Pirx3D/pirx/(list of files, cad)

Other CAD files:
Assembly/Case/boardCaseBack.ipt
Assembly/Case/boardCaseBottom.ipt
Assembly/Case/boardCaseSide.ipt
Assembly/Case/caseBack.ipt
Assembly/Case/caseBottom.ipt
Assembly/Case/caseFront.ipt
Assembly/Case/caseLeft.ipt
Assembly/Case/caseRight.ipt
Assembly/Case/caseTop.ipt
Assembly/SmallPieces/bowdenHolder.ipt
Assembly/SmallPieces/shaftPlug22.ipt
Assembly/SmallPieces/shaftPlug24.ipt
Assembly/SmallPieces/spoolHolder.iam
Assembly/SmallPieces/spoolHolderHolder.ipt
Assembly/SmallPieces/spoolHolder_a.ipt
Assembly/SmallPieces/spoolHolder_b.ipt
Assembly/SmallPieces/spoolHolder_c.ipt
Assembly/SmallPieces/xDriveShaft.ipt
Assembly/SmallPieces/xDriveShaftBack.iam
Assembly/SmallPieces/xDriveShaftFront.iam
Assembly/SmallPieces/xDriveShaftSupport.ipt
Assembly/SmallPieces/xDriveShaftSupportb.ipt
Assembly/SmallPieces/xMotor.iam
Assembly/SmallPieces/xMotorSpacer.ipt
Assembly/SmallPieces/xShaft.iam
Assembly/SmallPieces/xShaftHolder.ipt
Assembly/StockComponents/625ZZ_bearing.ipt
Assembly/StockComponents/695ZZ_bearing.ipt
Assembly/StockComponents/LM08UU.ipt
Assembly/StockComponents/NEMA17Stepper.ipt
Assembly/StockComponents/blowerFan50x15.ipt
Assembly/StockComponents/endstop.ipt
Assembly/StockComponents/endstopLever.ipt
Assembly/StockComponents/fan_60_60_10.ipt
Assembly/StockComponents/flexibleShaftCoupling.ipt
Assembly/StockComponents/gt2Belt188.ipt
Assembly/StockComponents/gt2Belt600.ipt
Assembly/StockComponents/gt2Belt760.ipt
Assembly/StockComponents/gt2_20_pulley.ipt
Assembly/StockComponents/printrboard.ipt
Assembly/StockComponents/trapeziodalNut10x2.ipt
Assembly/XCars/Xcr.iam
Assembly/XCars/XcrLeft.iam
Assembly/XCars/XcrLeftBeltTensioner.ipt
Assembly/XCars/XcrLeftPulleyAlu.ipt
Assembly/XCars/XcrLeftPulleyShaft.ipt
Assembly/XCars/XcrLeft_a.ipt
Assembly/XCars/XcrLeft_b.ipt
Assembly/XCars/XcrLeft_c.ipt
Assembly/XCars/XcrRight.iam
Assembly/XCars/XcrRightTop.ipt
Assembly/XCars/XcrRightXEndstopTrigger.ipt
Assembly/XCars/XcrRight_a.ipt
Assembly/XCars/XcrRight_b.ipt
Assembly/XCars/XcrRight_c.ipt
Assembly/XCars/Xshaft.ipt
Assembly/XCars/Yshaft.ipt
Assembly/YCar/dysza_abs2.ipt
Assembly/YCar/exAluBase.ipt
Assembly/YCar/exBolt.ipt
Assembly/YCar/exHeaterBlock.ipt
Assembly/YCar/exLever.ipt
Assembly/YCar/exNozzle.ipt
Assembly/YCar/exStSteelTube.ipt
Assembly/YCar/exTeflonTube.ipt
Assembly/YCar/exTop.ipt
Assembly/YCar/yCar.iam
Assembly/YCar/yCarBeltTensioner.ipt
Assembly/YCar/yCarBeltTensionerHolder.ipt
Assembly/YCar/yCarBottom.ipt
Assembly/YCar/yCarMid_a.ipt
Assembly/YCar/yCarMid_b.ipt
Assembly/YCar/yCarMid_c.ipt
Assembly/YCar/yCarMid_d.ipt
Assembly/YCar/yCarTop.ipt
Assembly/YCar/yCarTopper.ipt
Assembly/YCar/yCarWireHolder.ipt
Assembly/ZCar/DIN7991x30.ipt
Assembly/ZCar/Zshaft.ipt
Assembly/ZCar/trapeziodialScrew10x2.ipt
Assembly/ZCar/zCar.iam
Assembly/ZCar/zCarBack.ipt
Assembly/ZCar/zCarFront.ipt
Assembly/ZCar/zCarNutHolder.ipt
Assembly/ZCar/zCarPlate.ipt
Assembly/ZCar/zCarPlexiBed.ipt
Assembly/ZCar/zCar_a.ipt
Assembly/ZCar/zCar_b.ipt
Assembly/ZCar/zCar_c.ipt
Assembly/ZCar/zDrive.iam
Assembly/pirxMainAssembly.iam
