Pirx3D/pirx/Assembly/Pdfs/exAluBase.pdf

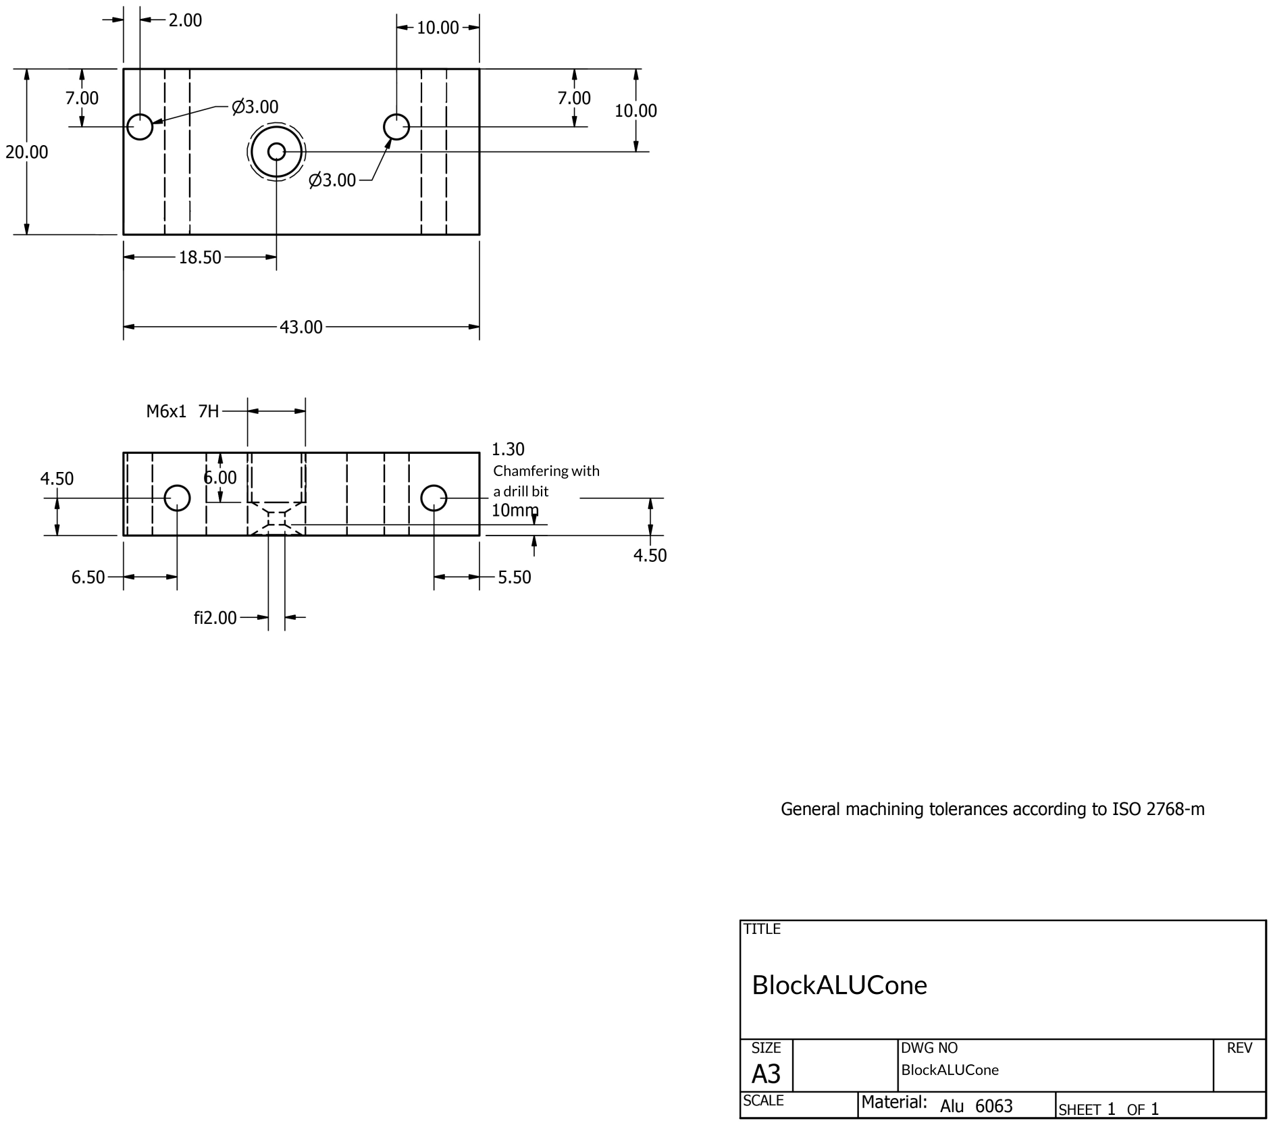
[picture p1: page 1]

Chamferingwith
adrillbit

BlockALUCone

# BlockALUCone
