Pirx3D/pirx/Assembly/Pdfs/exBolt.pdf

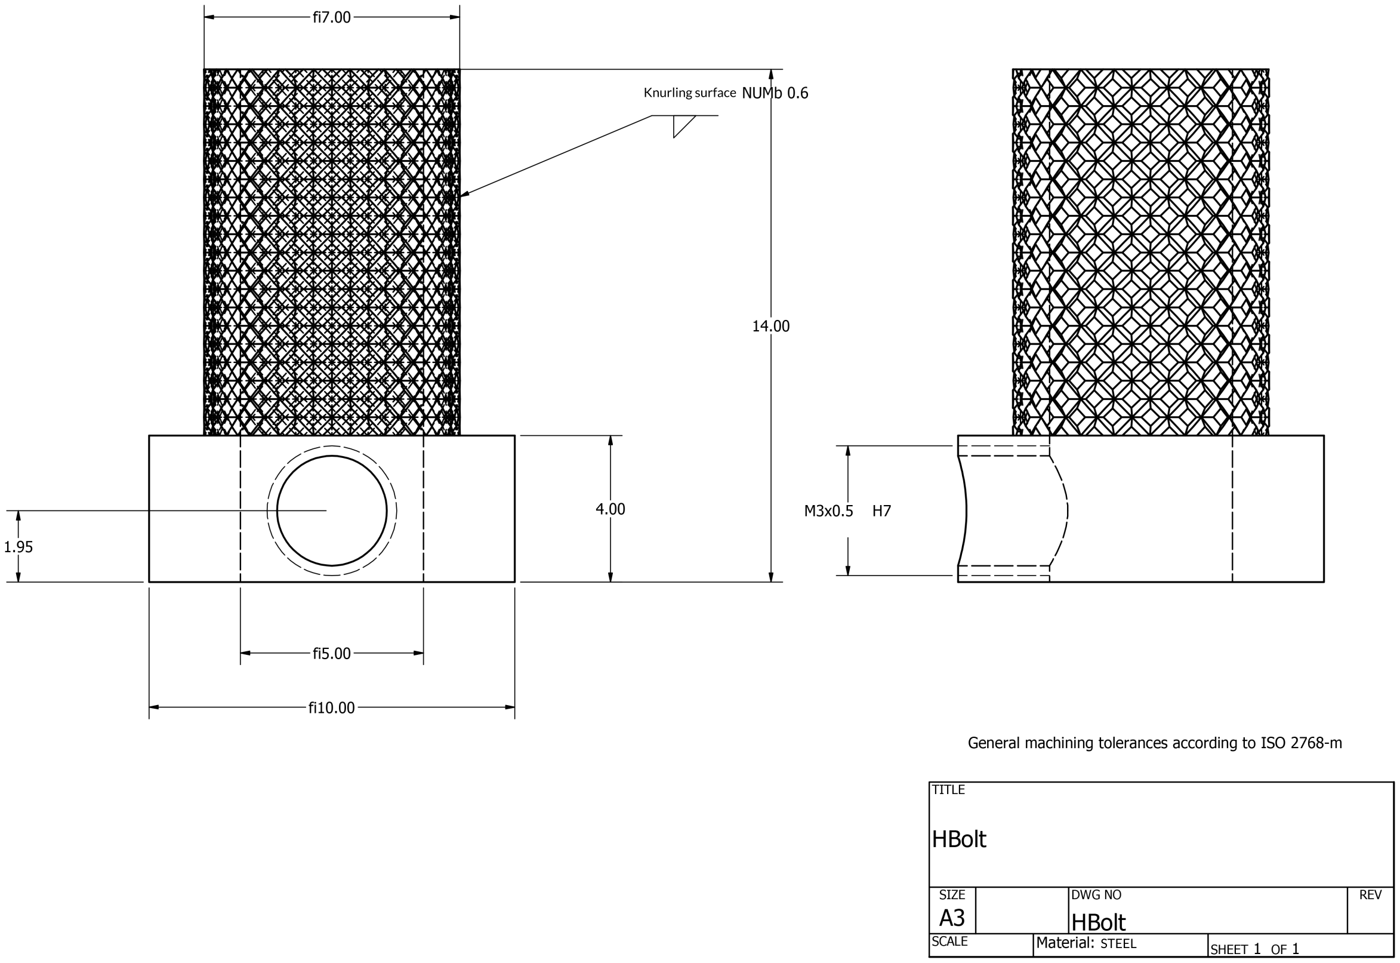
[picture p2: page 1]

Knurlingsurface

STEEL
