Pirx3D/pirx/Assembly/Pdfs/exHeatedBlock.pdf

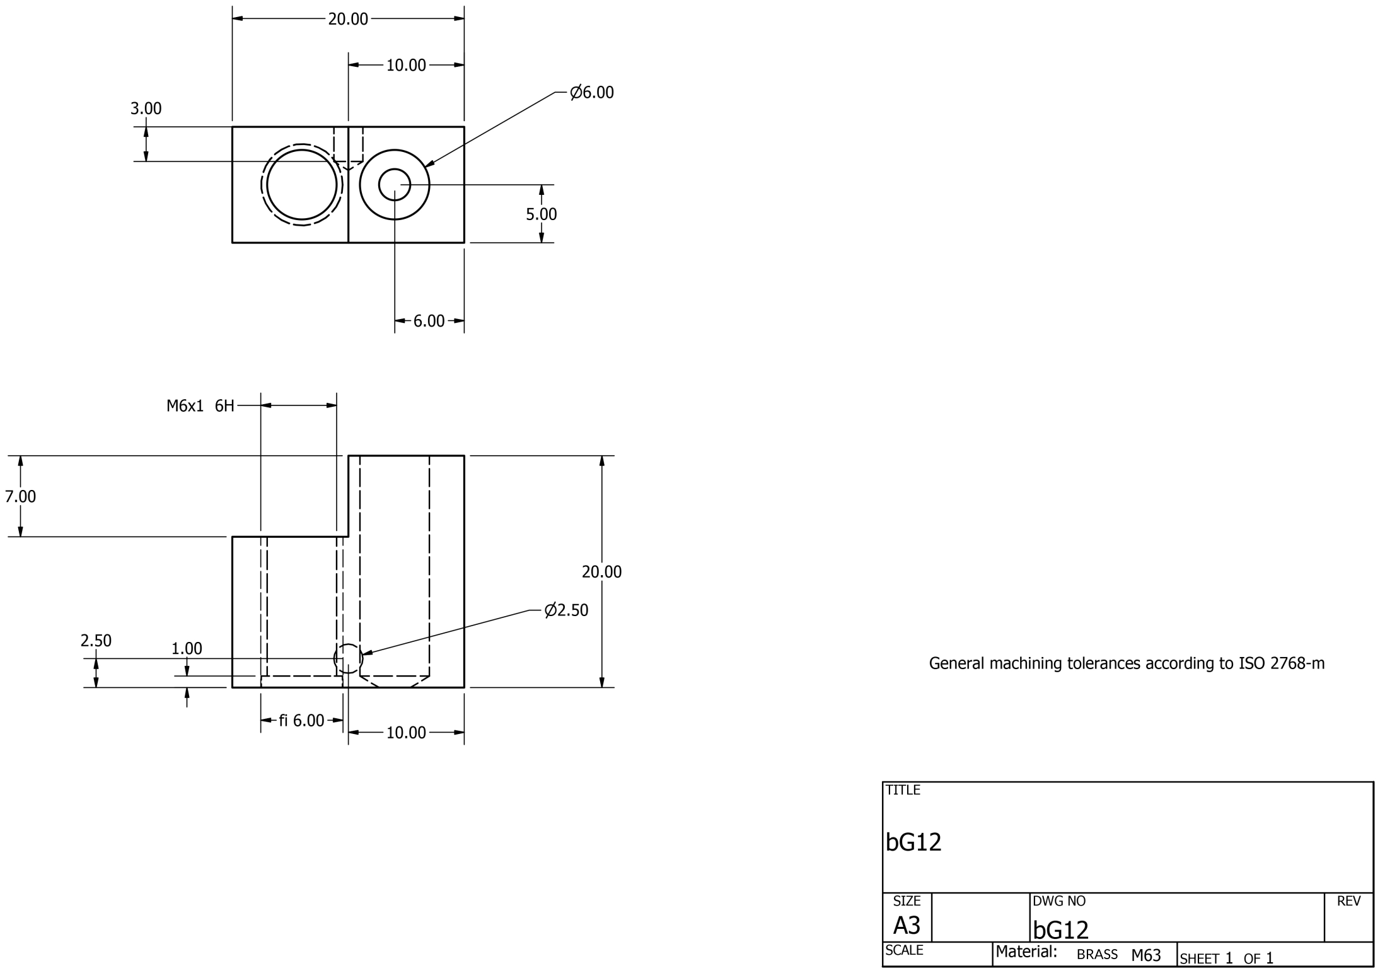
[picture p3: page 1]

BRASS
