Pirx3D/pirx/Assembly/Pdfs/exStSteelTube.pdf

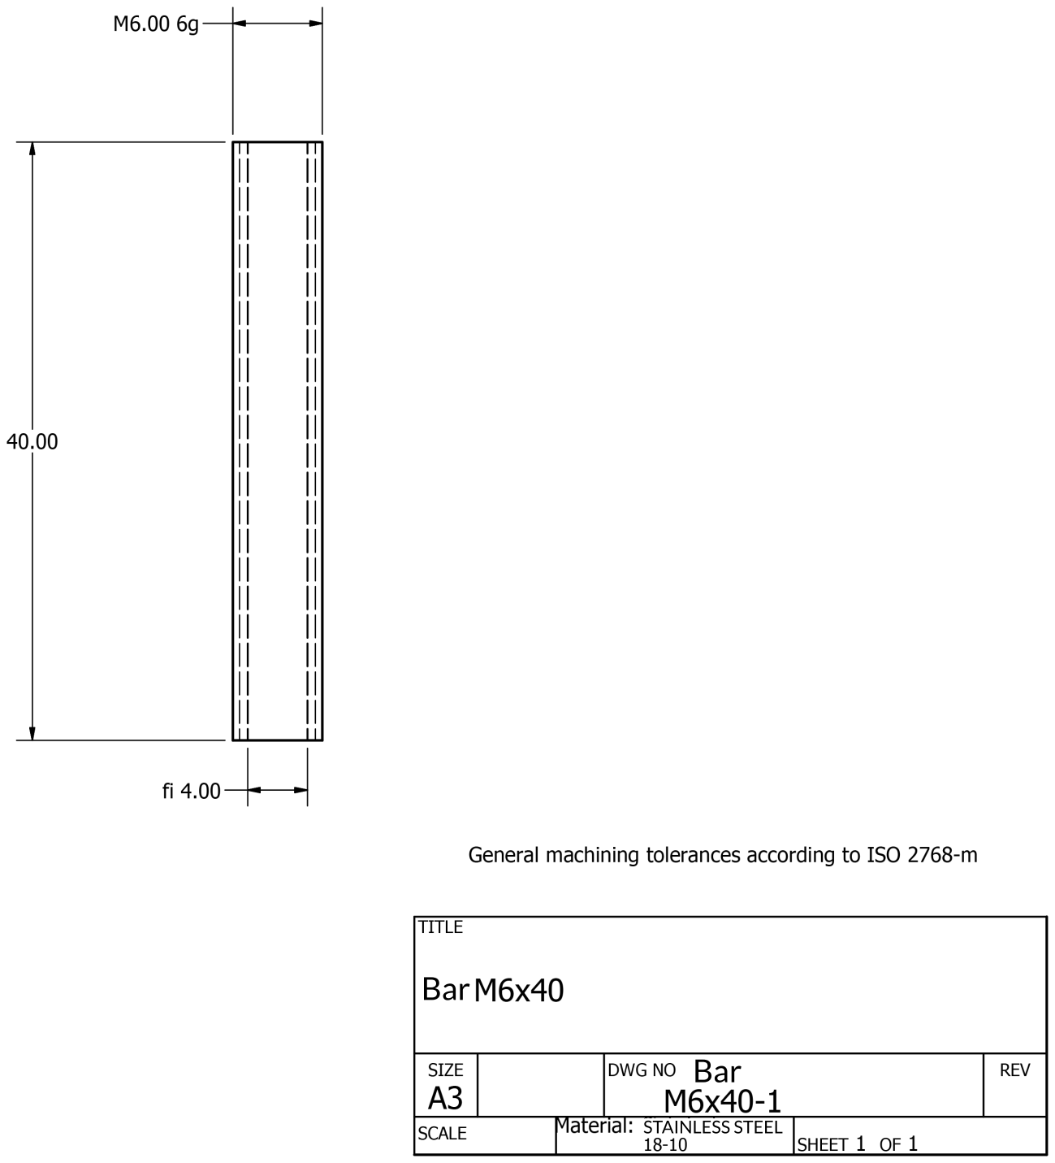
[picture p4: page 1]

# Bar

# Bar

STAINLESSSTEEL
