Pirx3D/pirx/Assembly/Pdfs/SCREWTr10x2.pdf

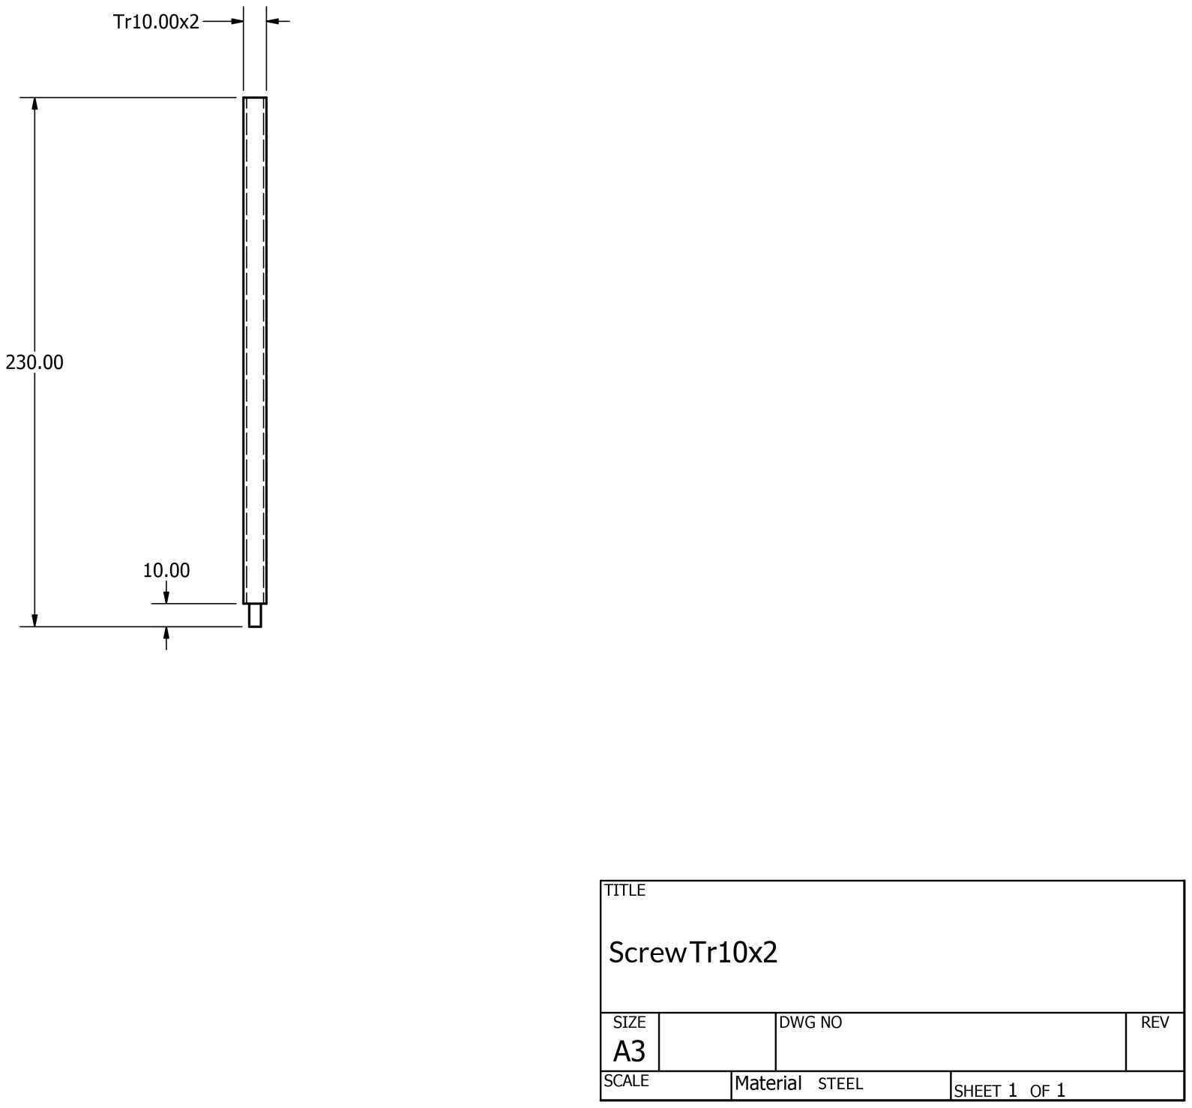
[picture p5: page 1]

STEEL
