Pirx3D/pirx/Board/Pirxboard.brd

## EAGLE design Board/Pirxboard.brd (2015-02-02)

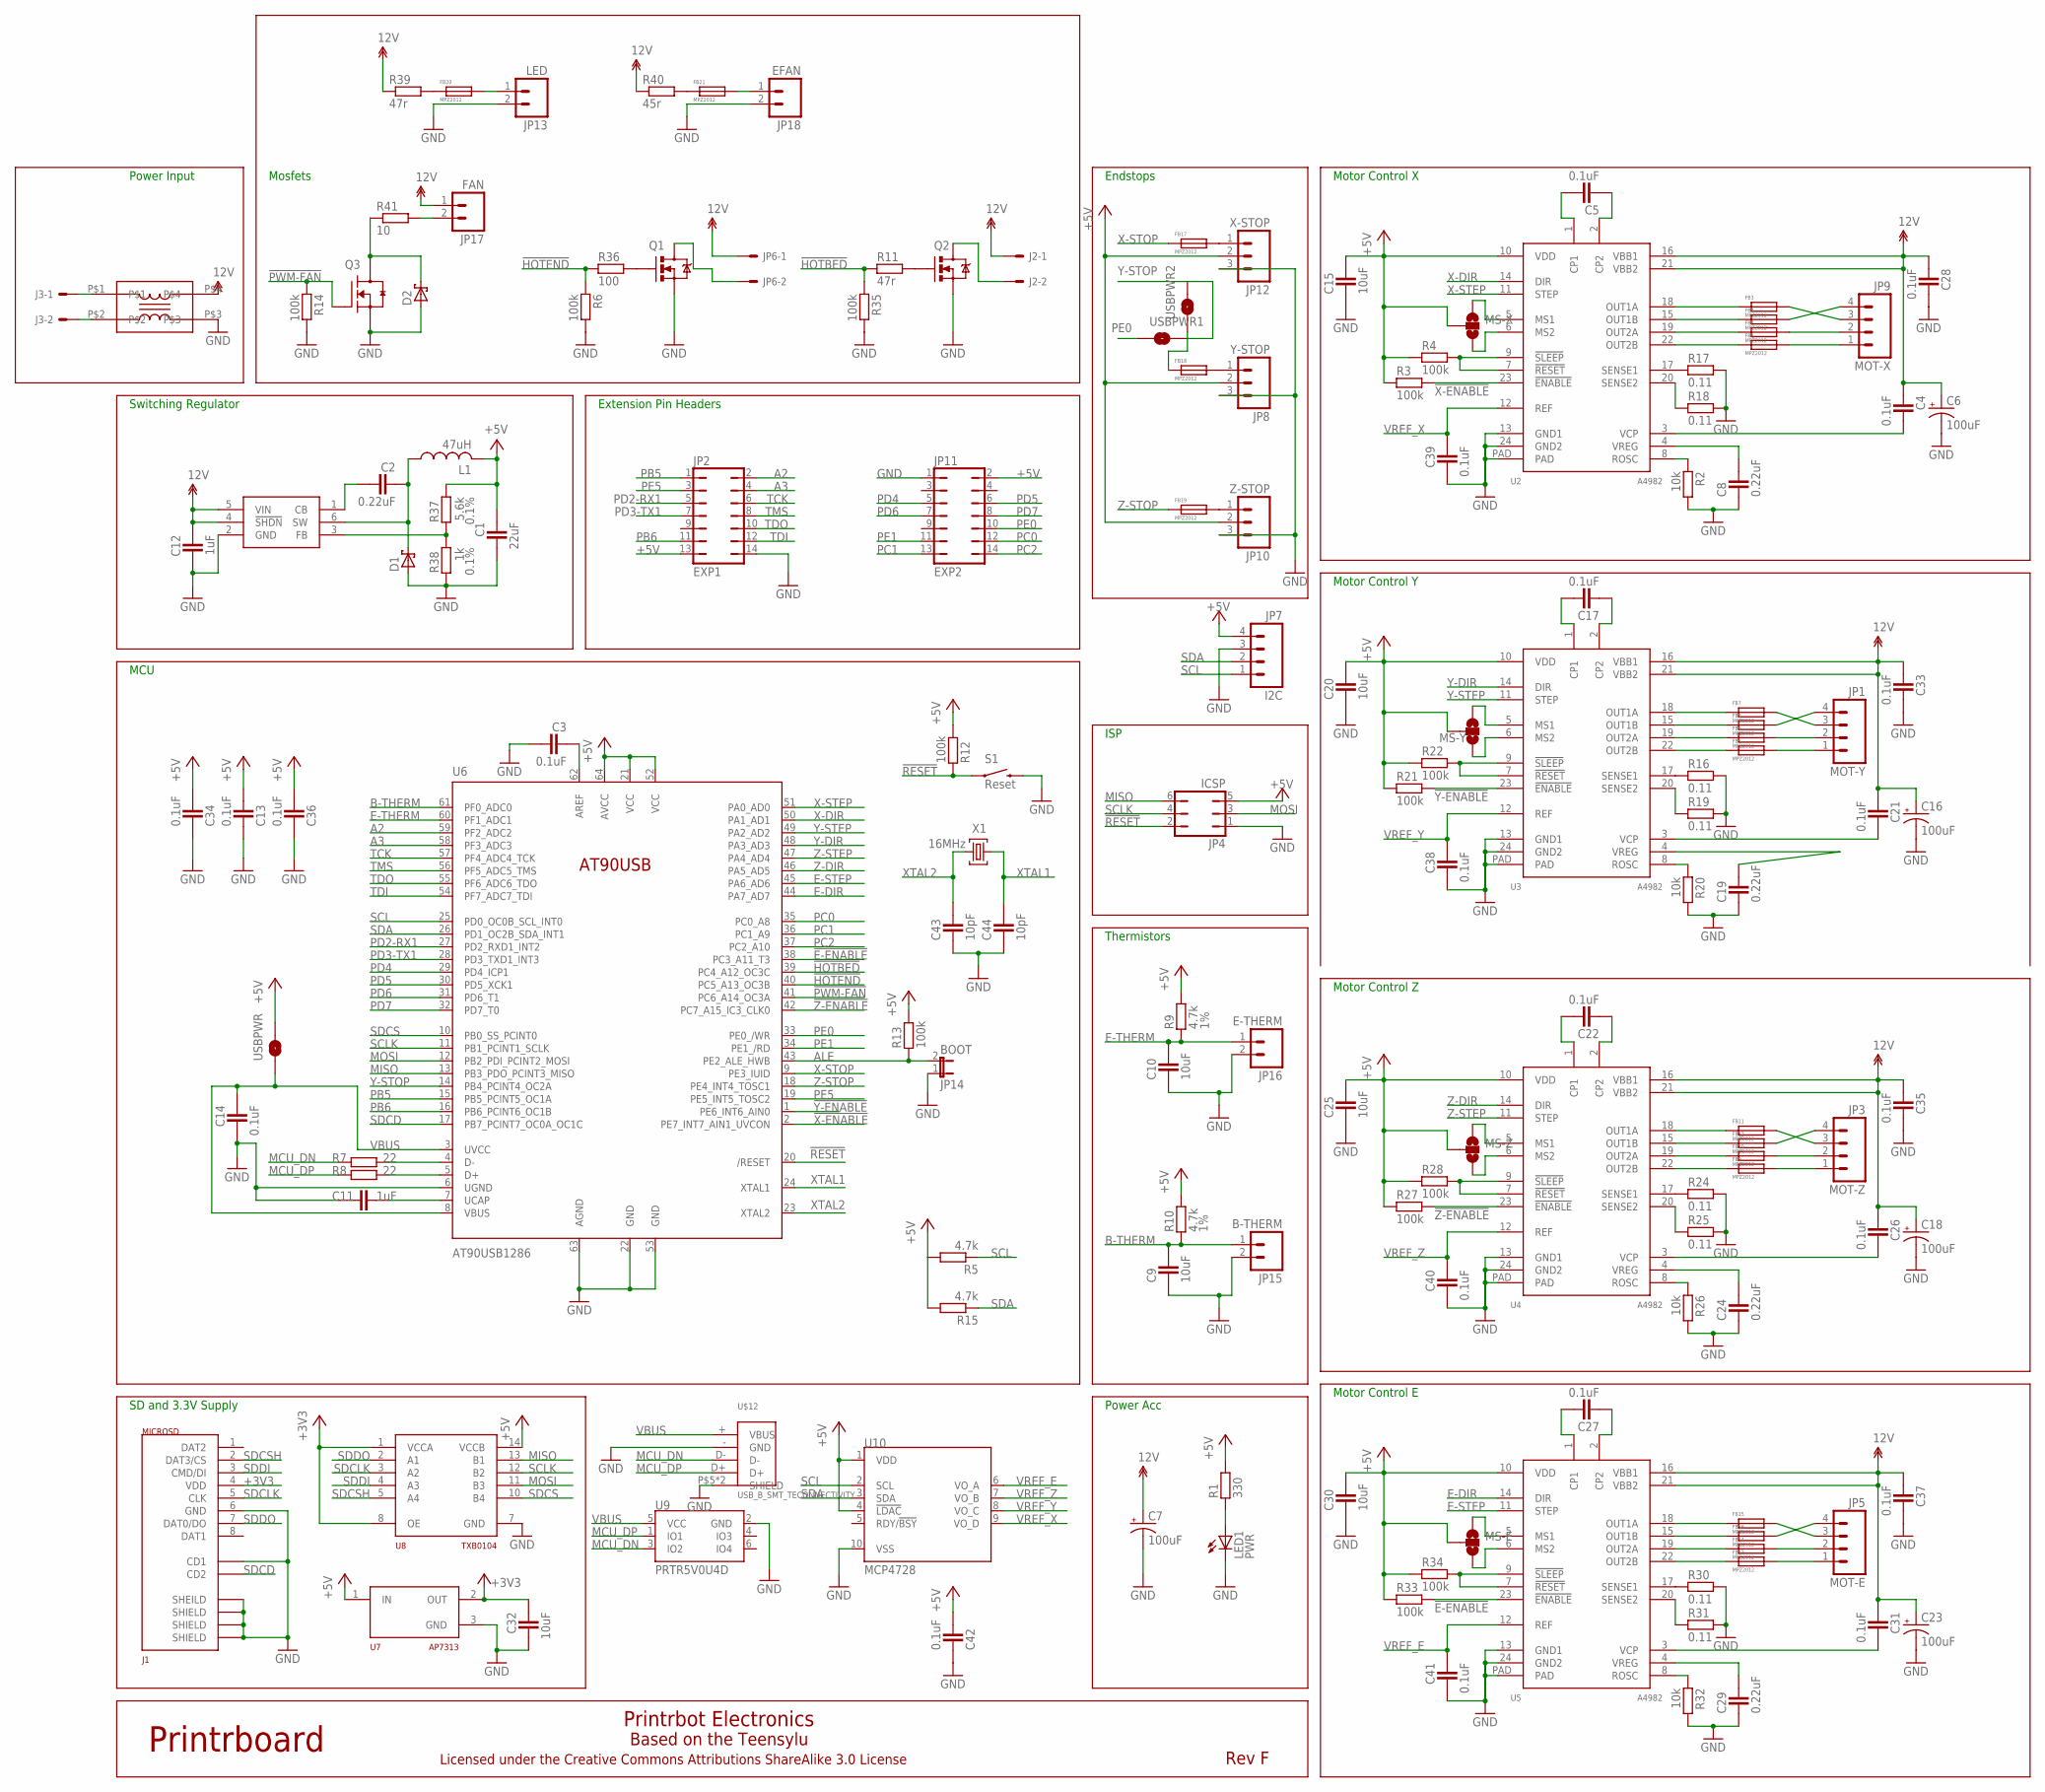
[picture p6: schematic Pirxboard.sch]

Parts:
C1: 22uF; CAPC2012X145AN
C2, C8, C19, C24, C29: 0.22uF; CAPC2012X145AN
C3, C4, C5, C13, C14, C17, C21, C22, C26, C27, C28, C31, C33, C34, C35, C36, C37, C38, C39, C40, C41, C42: 0.1uF; CAPC2012X145AN
C6, C7, C16, C18, C23: 100uF; PANASONIC_D
C9, C10, C15, C20, C25, C30, C32: 10uF; CAPC2012X145AN
C11, C12: 1uF; CAPC2012X145AN
C43, C44: 10pF; CAPC2012X145AN
D1, D2: SCH-DIODESMA; SMA
FB1, FB2, FB3, FB4, FB5, FB6, FB7, FB8, FB9, FB10, FB11, FB12, FB13, FB14, FB15, FB16, FB17, FB18, FB19, FB20, FB21: MPZ2012; FB2012
J1: MICROSD; AMPHENOL-MICROSD
J2, J3: PHOENIX-2POS-5MM-SCREW; PHOENIX-5MM-2POS
JP1: MOT-Y; MOLEX-1X4
JP2: EXP1; JP7Q
JP3: MOT-Z; MOLEX-1X4
JP4: ICSP; JP3Q
JP5: MOT-E; MOLEX-1X4
JP6: PHOENIX-2POS-5MM-SCREW; PHOENIX-5MM-2POS
JP7: I2C; MOLEX-1X4
JP8: Y-STOP; MOLEX-1X3
JP9: MOT-X; MOLEX-1X4
JP10: Z-STOP; MOLEX-1X3
JP11: EXP2; JP7Q
JP12: X-STOP; MOLEX-1X3
JP13: LED; 1X02
JP14: BOOT; 1X02
JP15: B-THERM; 1X02
JP16: E-THERM; 1X02
JP17: FAN; 1X02
JP18: EFAN; 1X02
L1: 47uH; SDR1006
LED1: PWR; CHIP-LED0805
MS-E: SOLDERJUMPER_2WAYCONNECTED; SJ_3_CONNECTED
MS-X: SOLDERJUMPER_2WAYCONNECTED; SJ_3_CONNECTED
MS-Y: SOLDERJUMPER_2WAYCONNECTED; SJ_3_CONNECTED
MS-Z: SOLDERJUMPER_2WAYCONNECTED; SJ_3_CONNECTED
Q1, Q2: RFP30N06LE; TO220V
Q3: RFP30N06LE; SOT95P280X135-3N
R1: 330; RESC2012X70N
R2, R20, R26, R32: 10k; RESC2012X70N
R3, R4, R6, R12, R13, R14, R21, R22, R27, R28, R33, R34, R35: 100k; RESC2012X70N
R5, R15: 4.7k; RESC2012X70N
R7, R8: 22; RESC2012X70N
R9, R10: 4.7k; RESC2012X70N; TOLERANCE 1%
R11: 47r; RESC2012X70N
R16, R17, R18, R19, R24, R25, R30, R31: 0.11; RESC2012X70N
R36: 100; RESC2012X70N
R37: 5.6k; RESC2012X70N; TOLERANCE 0.1%
R38: 1k; RESC2012X70N; TOLERANCE 0.1%
R39: 47r; R2512
R40: 45r; R2512
R41: 10; R2512
S1: Reset; TACTILE_SWITCH_TALL
U1: LM2841; TSOT6
U2, U3, U4, U5: A4982; TSSOP-24
U6: AT90USB1286; TQFP64-2
U7: AP7313; SOT23C
U8: TXB0104; TSSOP14
U9: PRTR5V0U4D; SOT23-6
U10: MCP4728; MSOP10
U$8: ACM1513-551-2PLACM1513; ACM1513
U$12: USB_B_SMT_TECONNECTIVITY; TECONECTIVITYUSBBSMT
USBPWR, USBPWR1, USBPWR2: SOLDERJUMPERNO; SJ_2S-NO
X1: 16MHz; NDK-XTAL

Connections:
12V: C4.1, C6.+, C7.+, C12.1, C16.+, C18.+, C21.1, C23.+, C26.1, C28.1, C31.1, C33.1, C35.1, C37.1, J2.P$1, JP6.P$1, JP17.1, R39.1, R40.1, U1.4 (!SHDN), U1.5 (VIN), U2.16 (VBB1), U2.21 (VBB2), U3.16 (VBB1), U3.21 (VBB2), U4.16 (VBB1), U4.21 (VBB2), U5.16 (VBB1), U5.21 (VBB2), U$8.P$4
!E-ENABLE: R33.2, U5.23 (!ENABLE), U6.38 (PC3_A11_T3)
!HOTBED: R11.1, R35.1, U6.39 (PC4_A12_OC3C)
!HOTEND: R6.1, R36.1, U6.40 (PC5_A13_OC3B)
!PWM-FAN: Q3.1 (G), R14.1, U6.41 (PC6_A14_OC3A)
!RESET: JP4.2, R12.1, S1.A2 (1), U6.20 (/RESET)
!X-ENABLE: R3.2, U2.23 (!ENABLE), U6.2 (PE7_INT7_AIN1_UVCON)
!Y-ENABLE: R21.2, U3.23 (!ENABLE), U6.1 (PE6_INT6_AIN0)
!Z-ENABLE: R27.2, U4.23 (!ENABLE), U6.42 (PC7_A15_IC3_CLK0)
+3V3: C32.1, J1.4 (VDD), U7.2 (OUT), U8.1 (VCCA), U8.8 (OE)
+5V: C1.1, C13.2, C15.2, C20.2, C25.2, C30.2, C34.2, C36.2, C42.2, JP2.13, JP4.5, JP7.4, JP8.2, JP10.2, JP11.2, JP12.2, L1.P$2 (2), MS-E.2, MS-X.2, MS-Y.2, MS-Z.2, R1.2, R3.1, R4.1, R5.2, R9.2, R10.2, R12.2, R13.2, R15.2, R21.1, R22.1, R27.1, R28.1, R33.1, R34.1, R37.1, U2.10 (VDD), U3.10 (VDD), U4.10 (VDD), U5.10 (VDD), U6.21 (VCC), U6.52 (VCC), U6.64 (AVCC), U7.1 (IN), U8.14 (VCCB), U10.1 (VDD), U10.4 (!LDAC), USBPWR.2
A2: JP2.2, U6.59 (PF2_ADC2)
A3: JP2.4, U6.58 (PF3_ADC3)
ALE: JP14.2, R13.1, U6.43 (PE2_ALE_HWB)
AREF: C3.1, U6.62 (AREF)
B-THERM: C9.2, JP15.1, R10.1, U6.61 (PF0_ADC0)
E-DIR: U5.14 (DIR), U6.44 (PA7_AD7)
E-STEP: U5.11 (STEP), U6.45 (PA6_AD6)
E-THERM: C10.2, JP16.1, R9.1, U6.60 (PF1_ADC1)
GND: C1.2, C3.2, C6.-, C7.-, C8.1, C9.1, C10.1, C11.1, C12.2, C13.1, C14.2, C15.1, C16.-, C18.-, C19.1, C20.1, C23.-, C24.1, C25.1, C28.2, C29.1, C30.1, C32.2, C33.2, C34.1, C35.2, C36.1, C37.2, C38.2, C39.2, C40.2, C41.2, C42.1, C43.1, C44.1, D1.A, D2.A, J1.6 (GND), J1.C1 (SHEILD), J1.C2 (SHIELD), J1.C3 (SHIELD), J1.C4 (SHIELD), J1.CD1, JP2.14, JP4.1, JP7.3, JP8.3, JP10.3, JP11.1, JP12.3, JP13.2, JP14.1, JP15.2, JP16.2, JP18.2, LED1.C, Q1.3 (S), Q2.3 (S), Q3.2 (S), R2.2, R6.2, R14.2, R16.2, R17.2, R18.2, R19.2, R20.2, R24.2, R25.2, R26.2, R30.2, R31.2, R32.2, R35.2, R38.2, S1.B2 (2), U1.2 (GND), U2.13 (GND1), U2.24 (GND2), U2.PAD, U3.13 (GND1), U3.24 (GND2), U3.PAD, U4.13 (GND1), U4.24 (GND2), U4.PAD, U5.13 (GND1), U5.24 (GND2), U5.PAD, U6.6 (UGND), U6.22 (GND), U6.53 (GND), U6.63 (AGND), U7.3 (GND), U8.7 (GND), U9.2 (GND), U10.10 (VSS), U$8.P$3, U$12.- (GND), U$12.P$5 (SHIELD), U$12.P$6 (SHIELD)
HOTBED-GND: J2.P$2, Q2.2 (D)
HOTEND-GND: JP6.P$2, Q1.2 (D)
MCU_DN: R7.1, U9.3 (IO2), U$12.D-
MCU_DP: R8.1, U9.1 (IO1), U$12.D+
MISO: JP4.6, U6.13 (PB3_PDO_PCINT3_MISO), U8.13 (B1)
MOSI: JP4.3, U6.12 (PB2_PDI_PCINT2_MOSI), U8.11 (B3)
unnamed: LED1.A, R1.1
unnamed: D2.C, Q3.3 (D), R41.1
unnamed: R7.2, U6.4 (D-)
unnamed: R8.2, U6.5 (D+)
unnamed: JP17.2, R41.2
unnamed: FB4.P$1 (1), U2.15 (OUT1B)
unnamed: Q2.1 (G), R11.2
unnamed: FB2.P$1 (1), U2.19 (OUT2A)
unnamed: C11.2, U6.7 (UCAP)
unnamed: FB3.P$2 (2), JP9.3
unnamed: C5.2, U2.1 (CP1)
unnamed: C5.1, U2.2 (CP2)
unnamed: R2.1, U2.8 (ROSC)
unnamed: R17.1, U2.17 (SENSE1)
unnamed: R18.1, U2.20 (SENSE2)
unnamed: C4.2, U2.3 (VCP)
unnamed: FB4.P$2 (2), JP9.4
unnamed: FB20.P$2 (2), JP13.1
unnamed: C8.2, U2.4 (VREG)
unnamed: FB1.P$1 (1), U2.22 (OUT2B)
unnamed: R4.2, U2.7 (!RESET), U2.9 (!SLEEP)
unnamed: R37.2, R38.1, U1.3 (FB)
unnamed: FB3.P$1 (1), U2.18 (OUT1A)
unnamed: FB7.P$1 (1), U3.18 (OUT1A)
unnamed: FB8.P$1 (1), U3.15 (OUT1B)
unnamed: FB8.P$2 (2), JP1.4
unnamed: MS-X.1, U2.5 (MS1)
unnamed: MS-X.3, U2.6 (MS2)
unnamed: C17.2, U3.1 (CP1)
unnamed: C17.1, U3.2 (CP2)
unnamed: FB7.P$2 (2), JP1.3
unnamed: R19.1, U3.20 (SENSE2)
unnamed: FB21.P$2 (2), JP18.1
unnamed: R20.1, U3.8 (ROSC)
unnamed: C19.2, U3.4 (VREG)
unnamed: R22.2, U3.7 (!RESET), U3.9 (!SLEEP)
unnamed: C21.2, U3.3 (VCP)
unnamed: R16.1, U3.17 (SENSE1)
unnamed: FB12.P$2 (2), JP3.4
unnamed: FB11.P$2 (2), JP3.3
unnamed: FB6.P$1 (1), U3.19 (OUT2A)
unnamed: MS-Y.1, U3.5 (MS1)
unnamed: MS-Y.3, U3.6 (MS2)
unnamed: C22.2, U4.1 (CP1)
unnamed: C22.1, U4.2 (CP2)
unnamed: R24.1, U4.17 (SENSE1)
unnamed: R25.1, U4.20 (SENSE2)
unnamed: FB21.P$1 (1), R40.2
unnamed: R26.1, U4.8 (ROSC)
unnamed: C24.2, U4.4 (VREG)
unnamed: R28.2, U4.7 (!RESET), U4.9 (!SLEEP)
unnamed: C26.2, U4.3 (VCP)
unnamed: FB5.P$1 (1), U3.22 (OUT2B)
unnamed: FB16.P$2 (2), JP5.4
unnamed: FB15.P$2 (2), JP5.3
unnamed: FB11.P$1 (1), U4.18 (OUT1A)
unnamed: MS-Z.1, U4.5 (MS1)
unnamed: MS-Z.3, U4.6 (MS2)
unnamed: C27.2, U5.1 (CP1)
unnamed: C27.1, U5.2 (CP2)
unnamed: R30.1, U5.17 (SENSE1)
unnamed: R31.1, U5.20 (SENSE2)
unnamed: FB20.P$1 (1), R39.2
unnamed: R32.1, U5.8 (ROSC)
unnamed: C29.2, U5.4 (VREG)
unnamed: R34.2, U5.7 (!RESET), U5.9 (!SLEEP)
unnamed: C31.2, U5.3 (VCP)
unnamed: FB12.P$1 (1), U4.15 (OUT1B)
unnamed: J3.P$1, U$8.P$1
unnamed: J3.P$2, U$8.P$2
unnamed: Q1.1 (G), R36.2
unnamed: MS-E.1, U5.5 (MS1)
unnamed: MS-E.3, U5.6 (MS2)
unnamed: FB2.P$2 (2), JP9.2
unnamed: C2.1, D1.C, L1.P$1 (1), U1.6 (SW)
unnamed: FB1.P$2 (2), JP9.1
unnamed: C2.2, U1.1 (CB)
unnamed: FB10.P$1 (1), U4.19 (OUT2A)
unnamed: FB9.P$1 (1), U4.22 (OUT2B)
unnamed: FB15.P$1 (1), U5.18 (OUT1A)
unnamed: FB16.P$1 (1), U5.15 (OUT1B)
unnamed: FB14.P$1 (1), U5.19 (OUT2A)
unnamed: FB13.P$1 (1), U5.22 (OUT2B)
unnamed: FB14.P$2 (2), JP5.2
unnamed: FB13.P$2 (2), JP5.1
unnamed: FB10.P$2 (2), JP3.2
unnamed: FB9.P$2 (2), JP3.1
unnamed: FB6.P$2 (2), JP1.2
unnamed: FB5.P$2 (2), JP1.1
unnamed: FB17.P$2 (2), JP12.1
unnamed: FB18.P$2 (2), JP8.1
unnamed: FB19.P$2 (2), JP10.1
PB5: JP2.1, U6.15 (PB5_PCINT5_OC1A)
PB6: JP2.11, U6.16 (PB6_PCINT6_OC1B)
PC0: JP11.12, U6.35 (PC0_A8)
PC1: JP11.13, U6.36 (PC1_A9)
PC2: JP11.14, U6.37 (PC2_A10)
PD2-RX1: JP2.5, U6.27 (PD2_RXD1_INT2)
PD3-TX1: JP2.7, U6.28 (PD3_TXD1_INT3)
PD4: JP11.5, U6.29 (PD4_ICP1)
PD5: JP11.6, U6.30 (PD5_XCK1)
PD6: JP11.7, U6.31 (PD6_T1)
PD7: JP11.8, U6.32 (PD7_T0)
PE0: JP11.10, U6.33 (PE0_/WR), USBPWR1.1
PE1: JP11.11, U6.34 (PE1_/RD)
PE5: JP2.3, U6.19 (PE5_INT5_TOSC2)
SCL: JP7.1, R5.1, U6.25 (PD0_OC0B_SCL_INT0), U10.2 (SCL)
SCLK: JP4.4, U6.11 (PB1_PCINT1_SCLK), U8.12 (B2)
SDA: JP7.2, R15.1, U6.26 (PD1_OC2B_SDA_INT1), U10.3 (SDA)
SDCD: J1.CD2, U6.17 (PB7_PCINT7_OC0A_OC1C)
SDCLK: J1.5 (CLK), U8.3 (A2)
SDCS: U6.10 (PB0_SS_PCINT0), U8.10 (B4)
SDCSH: J1.2 (DAT3/CS), U8.5 (A4)
SDDI: J1.3 (CMD/DI), U8.4 (A3)
SDDO: J1.7 (DAT0/DO), U8.2 (A1)
TCK: JP2.6, U6.57 (PF4_ADC4_TCK)
TDI: JP2.12, U6.54 (PF7_ADC7_TDI)
TDO: JP2.10, U6.55 (PF6_ADC6_TDO)
TMS: JP2.8, U6.56 (PF5_ADC5_TMS)
VBUS: C14.1, U6.3 (UVCC), U6.8 (VBUS), U9.5 (VCC), U$12.+ (VBUS), USBPWR.1
VREF_E: C41.1, U5.12 (REF), U10.6 (VO_A)
VREF_X: C39.1, U2.12 (REF), U10.9 (VO_D)
VREF_Y: C38.1, U3.12 (REF), U10.8 (VO_C)
VREF_Z: C40.1, U4.12 (REF), U10.7 (VO_B)
X-DIR: U2.14 (DIR), U6.50 (PA1_AD1)
X-STEP: U2.11 (STEP), U6.51 (PA0_AD0)
X-STOP: FB17.P$1 (1), U6.9 (PE3_IUID)
XTAL1: C44.2, U6.24 (XTAL1), X1.P$1 (1)
XTAL2: C43.2, U6.23 (XTAL2), X1.P$2 (2)
Y-DIR: U3.14 (DIR), U6.48 (PA3_AD3)
Y-STEP: U3.11 (STEP), U6.49 (PA2_AD2)
Y-STOP: FB18.P$1 (1), U6.14 (PB4_PCINT4_OC2A), USBPWR1.2, USBPWR2.1, USBPWR2.2
Z-DIR: U4.14 (DIR), U6.46 (PA5_AD5)
Z-STEP: U4.11 (STEP), U6.47 (PA4_AD4)
Z-STOP: FB19.P$1 (1), U6.18 (PE4_INT4_TOSC1)

Notes on the sheet:
Motor Control X
Motor Control Y
Motor Control Z
Motor Control E
ISP
Thermistors
Endstops
Mosfets
Power Acc
Printrboard
Rev F
Printrbot Electronics
Licensed under the Creative Commons Attributions ShareAlike 3.0 License
Extension Pin Headers
Switching Regulator
Based on the Teensylu
SD and 3.3V Supply
Power Input
MCU

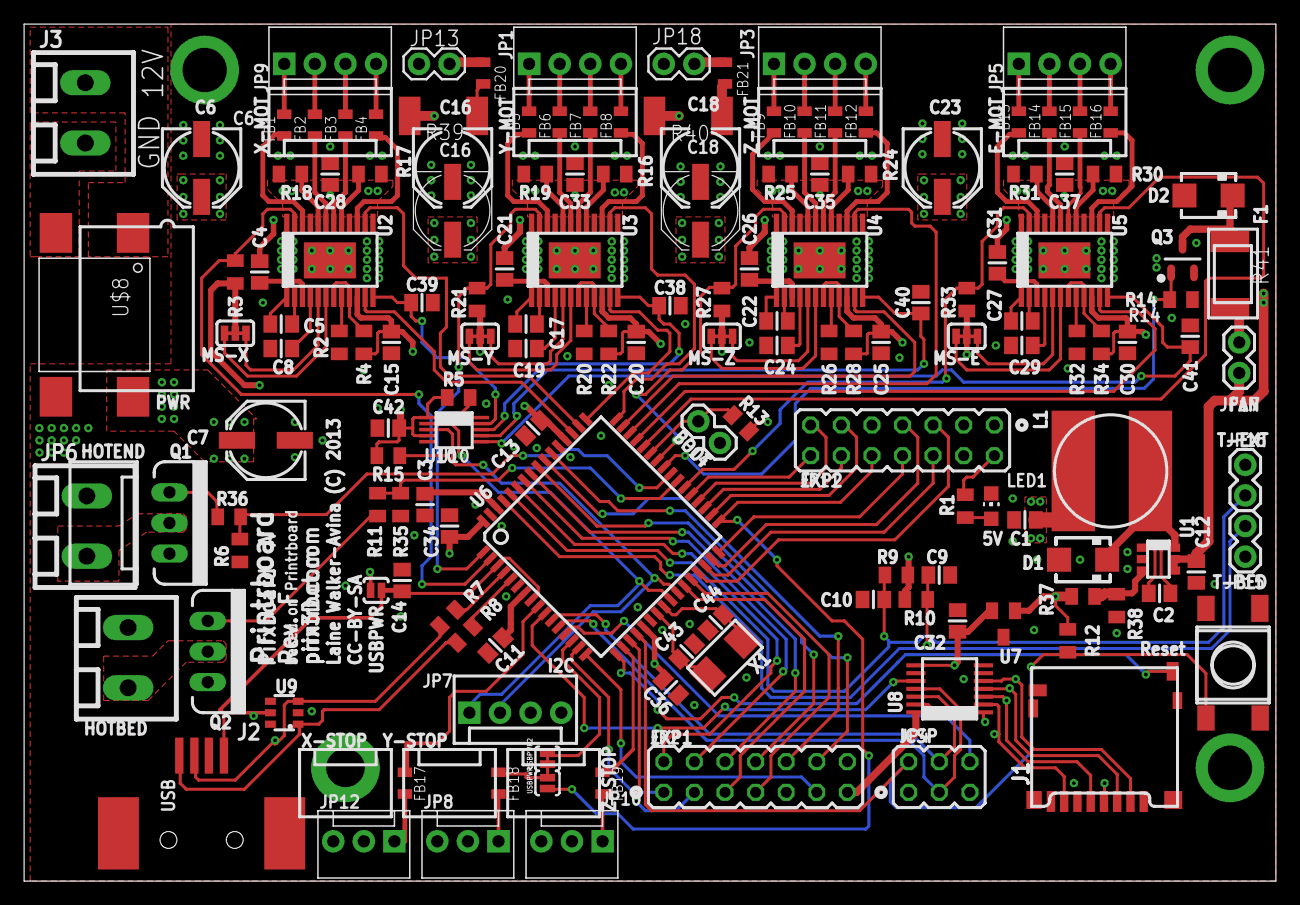
[picture p7: board Pirxboard.brd from above]

Board: 4 copper layers, 103.9 x 71.1 mm, 153 parts (0 on the bottom side), 161 nets.
