Pirx3D/pirx/(notices)

Notices in the files:
Board/Pirxboard.brd:
Laine Walker-Avina (C) 2013
CC-BY-SA
